buildwithnoknok/module-usb-led-16x/docs/measurements/2026-09-29_thermal_cut_resume_testbuild.csv

t_s | temp_c | vbus_mv | budget_ma | est_ma | therm_pct | vbus_pct | rail | therm_cut
0 | 54.7 | 5062 | 0 | 0 | 25 | 100 | 0 | 1
5 | 54.2 | 5076 | 0 | 0 | 25 | 100 | 0 | 1
10 | 53.3 | 5078 | 0 | 0 | 25 | 100 | 0 | 1
15 | 52.3 | 5070 | 0 | 0 | 25 | 100 | 0 | 1
20 | 51.2 | 5074 | 0 | 0 | 25 | 100 | 0 | 1
25 | 50.3 | 5080 | 0 | 0 | 25 | 100 | 0 | 1
30 | 49.3 | 5064 | 0 | 0 | 25 | 100 | 0 | 1
35 | 48.4 | 5070 | 0 | 0 | 25 | 100 | 0 | 1
40 | 47.9 | 5068 | 0 | 0 | 25 | 100 | 0 | 1
45 | 47.2 | 5076 | 0 | 0 | 25 | 100 | 0 | 1
50 | 46.3 | 5080 | 0 | 0 | 25 | 100 | 0 | 1
55 | 45.4 | 5072 | 0 | 0 | 25 | 100 | 0 | 1
60 | 44.6 | 5078 | 0 | 0 | 28 | 100 | 0 | 1
65 | 44.2 | 5076 | 0 | 0 | 31 | 100 | 0 | 1
70 | 43.4 | 5080 | 0 | 0 | 37 | 100 | 0 | 1
75 | 42.8 | 5076 | 0 | 0 | 41 | 100 | 0 | 1
80 | 42.4 | 5076 | 0 | 0 | 44 | 100 | 0 | 1
85 | 41.8 | 4958 | 221 | 216 | 49 | 100 | 1 | 0
90 | 41.4 | 4950 | 235 | 232 | 52 | 100 | 1 | 0
95 | 41.4 | 4952 | 235 | 232 | 52 | 100 | 1 | 0
100 | 41.4 | 4952 | 235 | 232 | 52 | 100 | 1 | 0
105 | 41.4 | 4952 | 235 | 232 | 52 | 100 | 1 | 0
110 | 41.4 | 4952 | 235 | 232 | 52 | 100 | 1 | 0
115 | 41.4 | 4952 | 235 | 232 | 52 | 100 | 1 | 0
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
