buildwithnoknok/module-usb-led-16x/docs/measurements/2026-09-29_heat_open_air_fw2.1.0.csv

t_s | temp_c | vbus_mv | budget_ma | est_ma | therm_pct | vbus_pct | rail | therm_cut
0 | 27.7 | 4800 | 450 | 449 | 100 | 100 | 1 | 0
5 | 27.7 | 4838 | 450 | 449 | 100 | 100 | 1 | 0
10 | 28.6 | 4826 | 450 | 449 | 100 | 100 | 1 | 0
15 | 29.8 | 4826 | 450 | 449 | 100 | 100 | 1 | 0
20 | 31.2 | 4840 | 450 | 449 | 100 | 100 | 1 | 0
25 | 32.4 | 4838 | 450 | 449 | 100 | 100 | 1 | 0
30 | 33.5 | 4810 | 450 | 449 | 100 | 100 | 1 | 0
35 | 34.6 | 4824 | 450 | 449 | 100 | 100 | 1 | 0
40 | 35.4 | 4818 | 450 | 449 | 100 | 100 | 1 | 0
45 | 36.6 | 4836 | 450 | 449 | 100 | 100 | 1 | 0
50 | 37.6 | 4838 | 450 | 449 | 100 | 100 | 1 | 0
55 | 38.4 | 4842 | 450 | 449 | 100 | 100 | 1 | 0
60 | 39.4 | 4840 | 450 | 449 | 100 | 100 | 1 | 0
65 | 40.3 | 4842 | 450 | 449 | 100 | 100 | 1 | 0
70 | 41.0 | 4834 | 450 | 449 | 100 | 100 | 1 | 0
75 | 41.9 | 4832 | 450 | 449 | 100 | 100 | 1 | 0
80 | 42.6 | 4840 | 450 | 449 | 100 | 100 | 1 | 0
85 | 43.2 | 4834 | 450 | 449 | 100 | 100 | 1 | 0
90 | 44.0 | 4846 | 450 | 449 | 100 | 100 | 1 | 0
95 | 44.5 | 4834 | 450 | 449 | 100 | 100 | 1 | 0
100 | 45.0 | 4844 | 450 | 449 | 100 | 100 | 1 | 0
105 | 45.8 | 4844 | 450 | 449 | 100 | 100 | 1 | 0
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
