buildwithnoknok/module-usb-led-16x/hardware/kicad/LED_Module_CH32V203.kicad_pcb

## KiCad design hardware/kicad/LED_Module_CH32V203.kicad_pcb (2026-09-29)

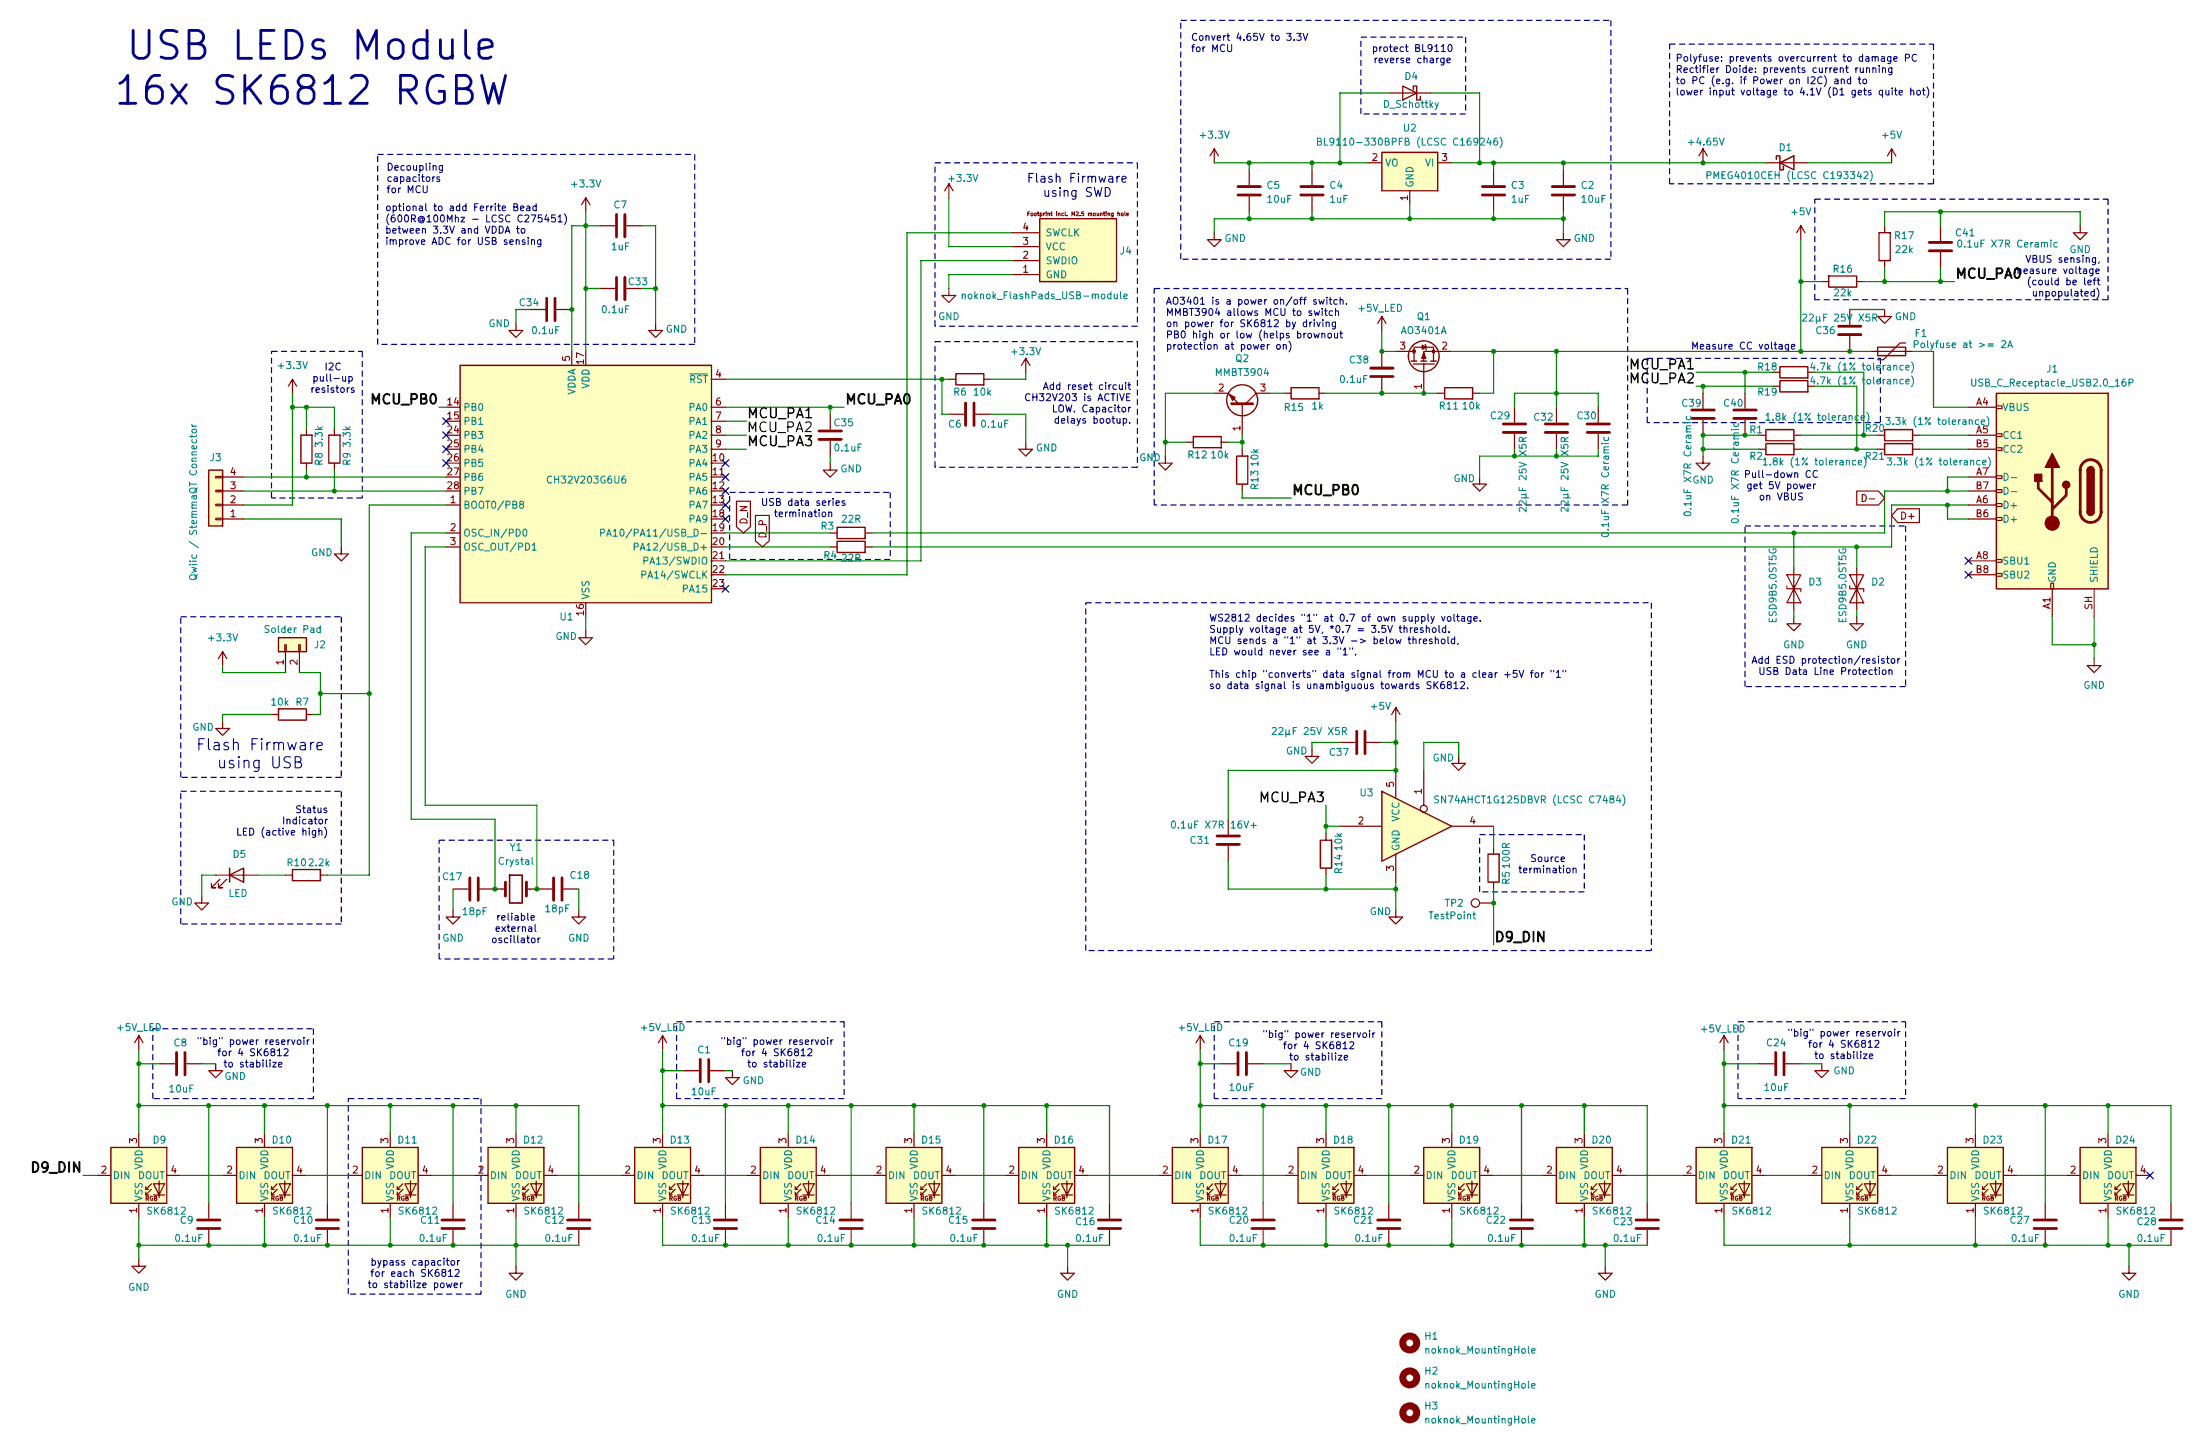
[picture p1: schematic LED_Module_CH32V203.kicad_sch, USB-C LEDs Module]

Parts:
C1, C2, C5, C8, C19, C24: 10uF; C_0603_1608Metric
C3, C4, C7: 1uF; C_0603_1608Metric
C6, C9, C10, C11, C12, C13, C14, C15, C16, C20, C21, C22, C23, C27, C28, C33, C34, C35, C38: 0.1uF; C_0603_1608Metric
C17, C18: 18pF; C_0603_1608Metric
C29, C32, C36, C37: 22µF 25V X5R; C_1206_3216Metric
C30, C39, C40, C41: 0.1uF X7R Ceramic; C_0603_1608Metric
C31: 0.1uF X7R 16V+; C_0603_1608Metric
D1: PMEG4010CEH (LCSC C193342); D_SOD-123
D2, D3: ESD9B5.0ST5G; D_SOD-923
D4: D_Schottky; D_SOD-323
D5: LED; LED_0603_1608Metric
D9, D10, D11, D12, D13, D14, D15, D16, D17, D18, D19, D20, D21, D22, D23, D24: SK6812; LED_SK6812_PLCC4_5.0x5.0mm_P3.2mm
F1: Polyfuse at >= 2A; Fuse_1206_3216Metric
H1, H2, H3: noknok_MountingHole; noknok_MountingHole_2.5mm_M2.5
J1: USB_C_Receptacle_USB2.0_16P
J2: Solder Pad; SolderJumper-2_P1.3mm_Open_TrianglePad1.0x1.5mm
J3: Qwiic / StemmaQT Connector; JST_SH_SM04B-SRSS-TB_1x04-1MP_P1.00mm_Horizontal_CHRIS
J4: noknok_FlashPads_USB-module; noknok_FlashPads_USB-module_1x4_M2.5
Q1: AO3401A; SOT-23
Q2: MMBT3904; SOT-23
R1, R2: 1.8k (1% tolerance); R_0603_1608Metric
R3, R4: 22R; R_0603_1608Metric
R5: 100R; R_0603_1608Metric
R6, R7, R11, R12, R13, R14: 10k; R_0603_1608Metric
R8, R9: 3.3k; R_0603_1608Metric
R10: 2.2k; R_0603_1608Metric
R15: 1k; R_0603_1608Metric
R16, R17: 22k; R_0603_1608Metric
R18, R19: 4.7k (1% tolerance); R_0603_1608Metric
R20, R21: 3.3k (1% tolerance); R_0603_1608Metric
TP2: TestPoint; TestPoint_THTPad_D1.0mm_Drill0.5mm
U1: CH32V203G6U6; WQFN-28-1EP_4x4mm_P0.4mm_EP2.7x2.7mm
U2: BL9110-330BPFB (LCSC C169246); SOT-223-3_TabPin2
U3: SN74AHCT1G125DBVR (LCSC C7484); SOT-23-5
Y1: Crystal; Crystal_SMD_3225-4Pin_3.2x2.5mm

Connections:
+3.3V: C4.1, C5.1, C7.1, C33.1, C34.2, D4.2 (A), J2.1, J3.2, J4.3 (VCC), R6.2, R8.2, R9.2, U1.5 (VDDA), U1.17 (VDD), U2.2 (VO)
+4.65V: C2.1, C3.1, D1.1 (K), D4.1 (K), U2.3 (VI)
+5V: C29.1, C30.1, C31.1, C32.1, C36.2, C37.2, D1.2 (A), F1.1, Q1.2 (S), R11.2, R16.2, U3.5 (VCC)
+5V_LED: C1.1, C8.1, C9.1, C10.1, C11.1, C12.1, C13.1, C14.1, C15.1, C16.1, C19.1, C20.1, C21.1, C22.1, C23.1, C24.1, C27.1, C28.1, C38.1, D9.3 (VDD), D10.3 (VDD), D11.3 (VDD), D12.3 (VDD), D13.3 (VDD), D14.3 (VDD), D15.3 (VDD), D16.3 (VDD), D17.3 (VDD), D18.3 (VDD), D19.3 (VDD), D20.3 (VDD), D21.3 (VDD), D22.3 (VDD), D23.3 (VDD), D24.3 (VDD), Q1.3 (D)
/D9_DIN: D9.2 (DIN), R5.1, TP2.1 (1_1)
/MCU_PA0: C35.1, C41.2, R16.1, R17.1, U1.6 (PA0)
/MCU_PA1: C40.1, R18.1, U1.7 (PA1)
/MCU_PA2: C39.1, R19.1, U1.8 (PA2)
/MCU_PA3: R14.2, U1.9 (PA3), U3.2
/MCU_PB0: R13.1, U1.14 (PB0)
D+: D2.1 (A1), J1.A6 (D+), J1.B6 (D+), R4.2
D-: D3.1 (A1), J1.A7 (D-), J1.B7 (D-), R3.2
D_N: R3.1, U1.19 (PA10/PA11/USB_D-)
D_P: R4.1, U1.20 (PA12/USB_D+)
GND: C1.2, C2.2, C3.2, C4.2, C5.2, C6.1, C7.2, C8.2, C9.2, C10.2, C11.2, C12.2, C13.2, C14.2, C15.2, C16.2, C17.1, C18.1, C19.2, C20.2, C21.2, C22.2, C23.2, C24.2, C27.2, C28.2, C29.2, C30.2, C31.2, C32.2, C33.2, C34.1, C35.2, C36.1, C37.1, C39.2, C40.2, C41.1, D2.2 (A2), D3.2 (A2), D5.1 (K), D9.1 (VSS), D10.1 (VSS), D11.1 (VSS), D12.1 (VSS), D13.1 (VSS), D14.1 (VSS), D15.1 (VSS), D16.1 (VSS), D17.1 (VSS), D18.1 (VSS), D19.1 (VSS), D20.1 (VSS), D21.1 (VSS), D22.1 (VSS), D23.1 (VSS), D24.1 (VSS), J1.A1 (GND), J1.A12 (GND), J1.B1 (GND), J1.B12 (GND), J1.SH (SHIELD), J3.1, J4.1 (GND), Q2.2 (E), R1.1, R2.1, R7.2, R12.1, R14.1, R17.2, U1.16 (VSS), U1.29 (VSS), U2.1 (GND), U3.1, U3.3 (GND)
unnamed: D5.2 (A), R10.1
unnamed: D9.4 (DOUT), D10.2 (DIN)
unnamed: D10.4 (DOUT), D11.2 (DIN)
unnamed: D11.4 (DOUT), D12.2 (DIN)
unnamed: D12.4 (DOUT), D13.2 (DIN)
unnamed: D13.4 (DOUT), D14.2 (DIN)
unnamed: D14.4 (DOUT), D15.2 (DIN)
unnamed: D15.4 (DOUT), D16.2 (DIN)
unnamed: D16.4 (DOUT), D17.2 (DIN)
unnamed: D17.4 (DOUT), D18.2 (DIN)
unnamed: D18.4 (DOUT), D19.2 (DIN)
unnamed: D19.4 (DOUT), D20.2 (DIN)
unnamed: D20.4 (DOUT), D21.2 (DIN)
unnamed: D21.4 (DOUT), D22.2 (DIN)
unnamed: D22.4 (DOUT), D23.2 (DIN)
unnamed: D23.4 (DOUT), D24.2 (DIN)
unnamed: F1.2, J1.A4 (VBUS), J1.A9 (VBUS), J1.B4 (VBUS), J1.B9 (VBUS)
unnamed: J1.A5 (CC1), R20.2
unnamed: J1.B5 (CC2), R21.2
unnamed: J2.2, R7.1, R10.2, U1.1 (BOOT0/PB8)
unnamed: J3.3, R9.1, U1.28 (PB7)
unnamed: J3.4, R8.1, U1.27 (PB6)
unnamed: J4.4 (SWCLK), U1.22 (PA14/SWCLK)
unnamed: J4.2 (SWDIO), U1.21 (PA13/SWDIO)
unnamed: C38.2, Q1.1 (G), R11.1, R15.2
unnamed: Q2.1 (B), R12.2, R13.2
unnamed: Q2.3 (C), R15.1
unnamed: R1.2, R18.2, R20.1
unnamed: R5.2, U3.4
unnamed: R2.2, R19.2, R21.1
unnamed: C17.2, U1.2 (OSC_IN/PD0), Y1.1
unnamed: C18.2, U1.3 (OSC_OUT/PD1), Y1.2
unnamed: C6.2, R6.1, U1.4 (~RST)

Notes on the sheet:
Polyfuse: prevents overcurrent to damage PC Rectifier Doide: prevents current running to PC (e.g. if Power on I2C) and to lower input voltage to 4.1V (D1 gets quite hot)
Pull-down CC get 5V power on VBUS
"big" power reservoir for 4 SK6812 to stabilize
Source termination
Add reset circuit CH32V203 is ACTIVE LOW. Capacitor delays bootup.
USB data series termination
Measure CC voltage
optional to add Ferrite Bead (600R@100Mhz - LCSC C275451) between 3.3V and VDDA to improve ADC for USB sensing
Decoupling capacitors for MCU
VBUS sensing, measure voltage (could be left unpopulated)
reliable external oscillator
Status Indicator LED (active high)
WS2812 decides "1" at 0.7 of own supply voltage. Supply voltage at 5V, *0.7 = 3.5V threshold. MCU sends a "1" at 3.3V -> below threshold, LED would never see a "1". This chip "converts" data signal from MCU to a clear +5V for "1" so data signal is unambiguous towards SK6812.
Flash Firmware using USB
USB LEDs Module 16x SK6812 RGBW
Flash Firmware using SWD
Add ESD protection/resistor USB Data Line Protection
AO3401 is a power on/off switch. MMBT3904 allows MCU to switch on power for SK6812 by driving PB0 high or low (helps brownout protection at power on)
Convert 4.65V to 3.3V for MCU
protect BL9110 reverse charge
bypass capacitor for each SK6812 to stabilize power
I2C pull-up resistors

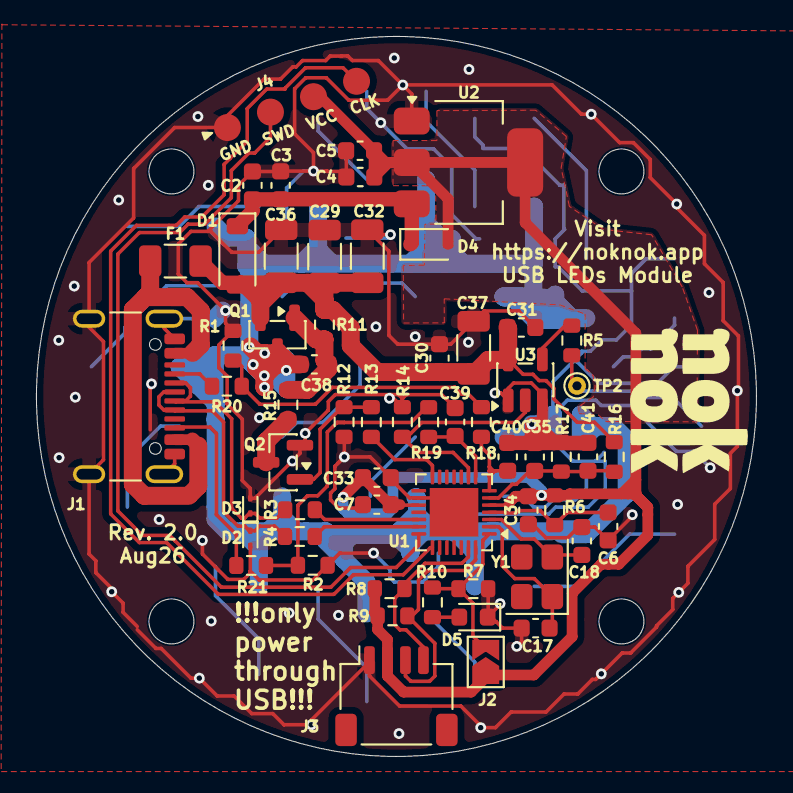
[picture p2: board LED_Module_CH32V203.kicad_pcb from above]

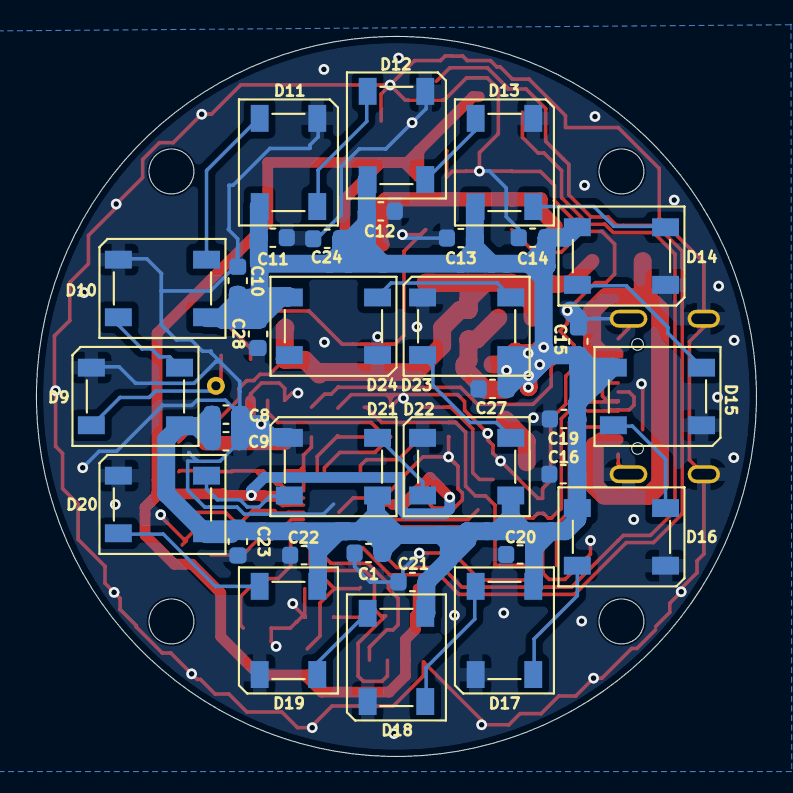
[picture p3: board LED_Module_CH32V203.kicad_pcb from below]

Board: 2 copper layers, 40.0 x 40.0 mm, 96 parts (34 on the bottom side), 48 nets.
