buildwithnoknok/module-usb-led-16x/(commit log)

2026-08-28 docs: README describes the 16x RGBW round board and flags that the inherited 8x firmware will not drive it
2026-09-29 fw 2.0.0 (source, not yet bench-tested): first firmware for the 16x RGBW board
    - 16 LEDs, GRBW 32 bit/LED, SK6812 timing (T0H 0.31 us, T1H 0.60 us, reset 100 us)
    - TIM2_CH4 PWM + DMA only (no bit-banging); output-compare preload on so no pulse
    is clipped mid-bit; DMA priority very high
    - PB0 LED-rail sequencing: PA3 held low from the first instruction, rail on before
    the first non-black frame, rail off when the frame is all black
    - PB8 status LED held low by the app
    - fixed 450 mA current cap (step 3 makes it CC/VBUS driven)
    - new white-channel commands 0x11/0x12/0x14/0x18/0x21; RGB commands unchanged
    (W=0) except 0x04 = 48 bytes; 50 ms parser timeout drops incomplete commands
    firmwar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
2026-09-29 fw 2.0.1: lossless USB receive (ring buffer + NAK flow control)
    Bench bug 29 Sep 2026: ch32fun usbd.c's printf RX path has a 64-byte buffer
    that discards the oldest bytes when a second packet lands before the main
    loop polls. A 65-byte 0x14 frame (64 + 1 byte packets) lost its command byte;
    the colour bytes were then parsed as commands (0x00 = ALL OFF -> dark ring).
    - FUNCONF_USE_USBPRINTF = 0 (+ FUNCONF_NULL_PRINTF); the app implements the
    CDC callbacks itself: 256-byte ring filled in the USB IRQ, IRQ masked when
    less than one packet of room is left so the endpoint NAKs and the host
    retries; the main loop drains the ring and unmasks.
    - Bench: 300 back-to-back 0x14 frames. 2.0.0 went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
2026-09-29 fw 2.0.2: bench-validated on the rev 2.0 pilot board; release bin/hex, docs, bench tools
    - current model 20 -> 12 mA per channel at 255, calibrated with a KWS-X1 inline on
    USB-C: LEDs off 0.03 W, 16x white die 0.95 W, all channels capped 1.78 W (~0.35 A)
    - firmware/bin: v2.0.2 app (7108 B, linked at 0x2000, runs under the USB bootloader)
    - firmware/readme.md: 16x command set incl. white commands, LED layout (0-11 outer
    ring clockwise, 12-15 inner anti-clockwise), SWD bring-up, measured power,
    audible-rustle hardware note, v2.0.2 change record
    - README: status updated (firmware validated; remaining work listed)
    - tools/bench: flash_leds16.sh (SWD write + readback compare, no -t: minichl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
2026-09-29 fw 2.1.0 (source, bench validation in progress): power governor + temperature
    - ADC1 reads VBUS (PA0 x2), CC1/CC2 (PA1/PA2, analog, no pulls), die temperature
    (ch16, WCH factory calibration word @0x1FFFF720 = [mV | degC<<16], 4.3 mV/C)
    and VREFINT (ch17) for true mV, 10x per second
    - LED budget = CC source limit (default 450 mA; 1.5 A / 3 A -> 1000 mA)
    x VBUS factor (dim while sagging, rail off below 4.1 V)
    x thermal factor (dim from 55 C to 25 % at 70 C, rail off at 75 C until < 65 C)
    thresholds are first guesses until the heat-up curve is measured
    - 0x30 GET_STATUS (16 B, stable layout for the app: temperature etc.),
    0x3F GET_SENSOR_RAW (18 B, bench/debug)
    - tools/bench/status_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
2026-09-29 fw 2.1.1: power governor + temperature, bench-validated; release bin/hex, docs, measurements
    - 2.1.1 fixes 2.1.0: thermal derating never reached a static frame (re-draw compared
    the budget tick-to-tick; slow derating never moved 2 % per 100 ms tick). Now
    compared against the budget the LEDs were last drawn with.
    - validated: VBUS read 5.04 V = KWS-X1; factory temp cal present (1395 mV @ 28 C);
    low-threshold TEST build: cut at 54.7 C -> back on by itself at 41.4 C -> holds
    ~43 C; stress test PASS; flashed over USB (usb_flash.py)
    - docs/measurements: open-air heat curve (1.8 W -> ~57-58 C) + cut/resume log
    - firmware/readme: 0x30 GET_STATUS layout (stable, for the app), governor, heat,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
2026-09-29 readme: the Pico driver for the 16x exists now (NoknokLEDs16, DEV-46)
2026-09-29 mechanical: housing profile for the rev 2.0 round board, replaces the stale 8x copy
2026-10-02 DEV-28 fw 2.2.1: fix USB-C source detection (CC divider), hard LED-rail check in the driver
    - CC1/CC2 are read through the board's 3.3k + 1.8k Rd divider (PA1/PA2 see 35 percent
    of CC); now scaled back to the line voltage. Before: a 3 A USB-C charger (CC 1.63 V)
    read 0.57 V, was treated as default USB, budget stuck at 450 mA. Bench after the fix:
    budget 1000 mA, 0.626 A at 2.9 W (Pi4 path), 0.63 A at 3.18 W (5 V 3 A USB-C charger)
    - ws_show() refuses to clock LED data unless the PB0 output register says the LED rail
    is on (DEV-28 acceptance: PA3/PB0 rule enforced in the driver itself)
    - BENCH_FULL_ON_BOOT compile switch (test builds only, off in this release) to check
    the governor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
2026-10-04 housing.json: print-tuned values from the 2026-10-03 housing print (see notes)
2026-10-17 DEV-98: firmware/index.json for LEDs 16x (usb_leds_16x 2.2.1)
    Size and CRC32 generated from firmware/bin/noknok_leds.bin (commit c93ff55).
    No layout field: USB module, per Ecosystem software/firmware-index.md.
